dodomarg/cad-mouse-mk2/enclosure/FreeCAD/original/README.md

License: CC-BY-NC-SA 4.0

The files in this folder were created by relikd.

The original design is by [Salim Benbouziyane](https://github.com/sb-ocr/cad-mouse-mk2).
