dodomarg/cad-mouse-mk2/enclosure/FreeCAD/print-improvements/base-shell-bottom.FCStd

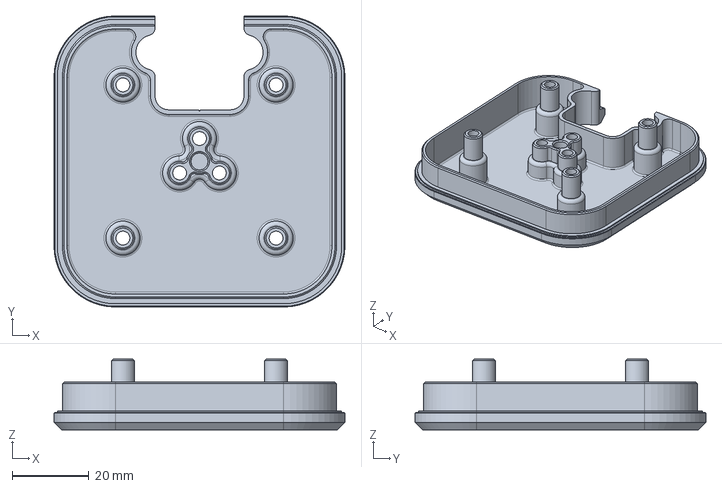
[picture p2: CAD file, 2026-06-14]
enclosure/FreeCAD/print-improvements/base-shell-bottom.FCStd
76.0 x 76.0 x 18.5 mm
