dodomarg/cad-mouse-mk2/enclosure/fusion/stl/knob.stl

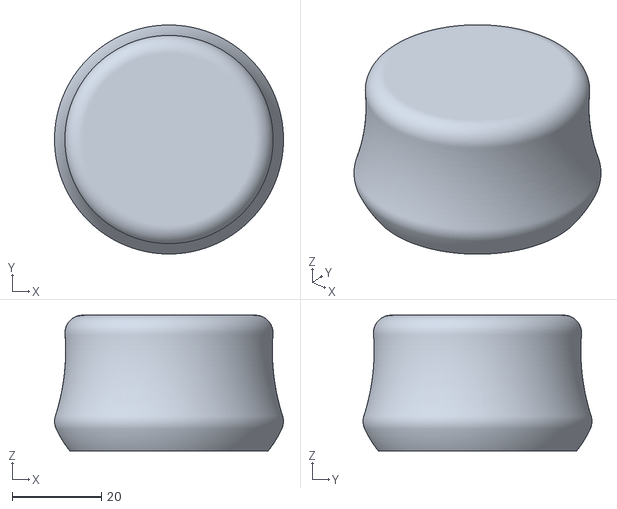
[picture p3: CAD file, 2026-06-14]
enclosure/fusion/stl/knob.stl
51.5 x 51.5 x 30.5
