dodomarg/cad-mouse-mk2/pcbs/src/SK6812 SIDE-A--3DModel-STEP-269445.STEP

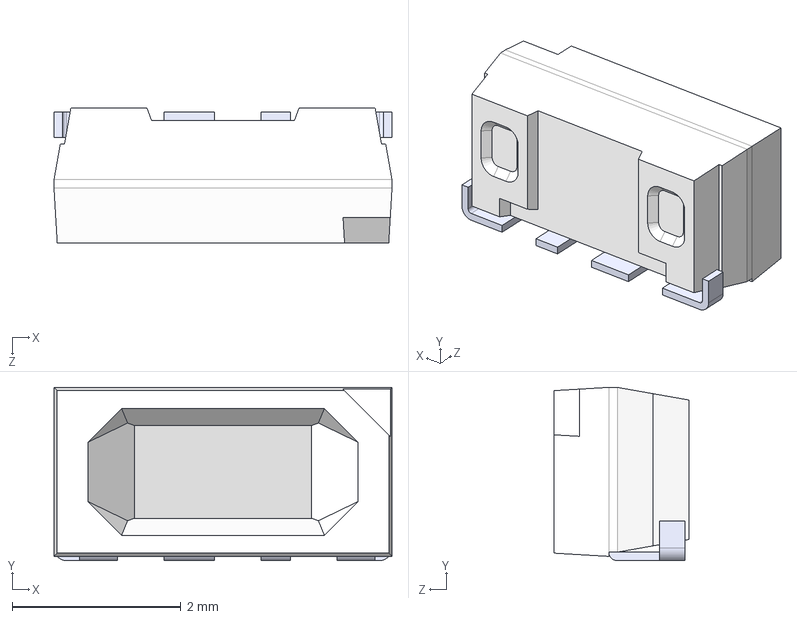
[picture p4: CAD file, 2026-06-14]
pcbs/src/SK6812 SIDE-A--3DModel-STEP-269445.STEP
4.00 x 2.05 x 1.60 mm
