dodomarg/cad-mouse-mk2/enclosure/FreeCAD/original/stem.FCStd

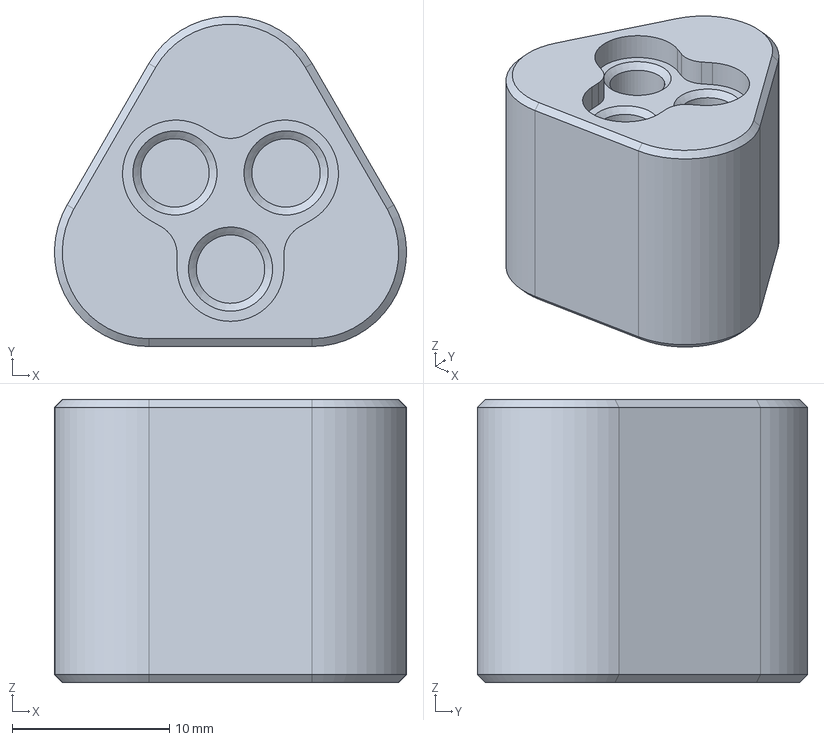
[picture p5: CAD file, 2026-06-14]
enclosure/FreeCAD/original/stem.FCStd
22.4 x 21.0 x 18.0 mm
