dodomarg/cad-mouse-mk2/enclosure/FreeCAD/print-improvements/button.FCStd

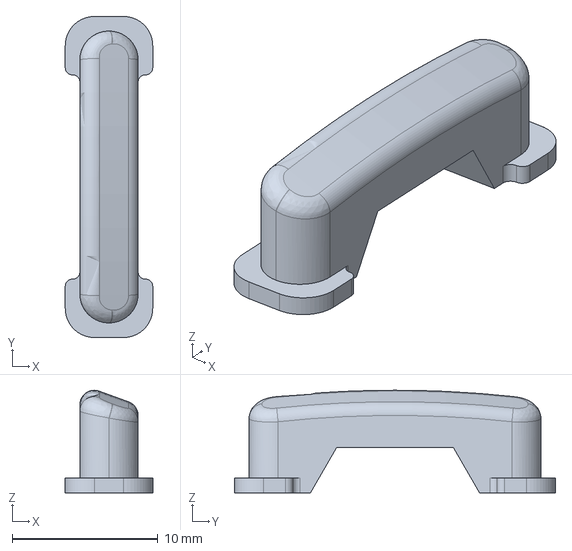
[picture p6: CAD file, 2026-06-14]
enclosure/FreeCAD/print-improvements/button.FCStd
6.00 x 22.0 x 7.03 mm
