dodomarg/cad-mouse-mk2/enclosure/fusion/stl/base_separator.stl

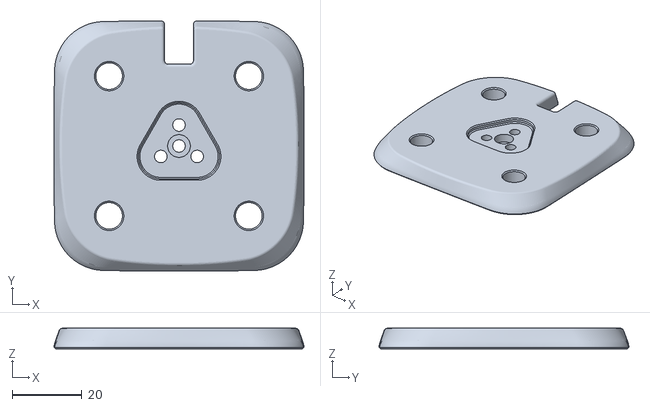
[picture p7: CAD file, 2026-06-14]
enclosure/fusion/stl/base_separator.stl
71.6 x 71.6 x 5.90
