dodomarg/cad-mouse-mk2/pcbs/src/TS32-7-35-BK-B-160-RA-SMT-TR.step

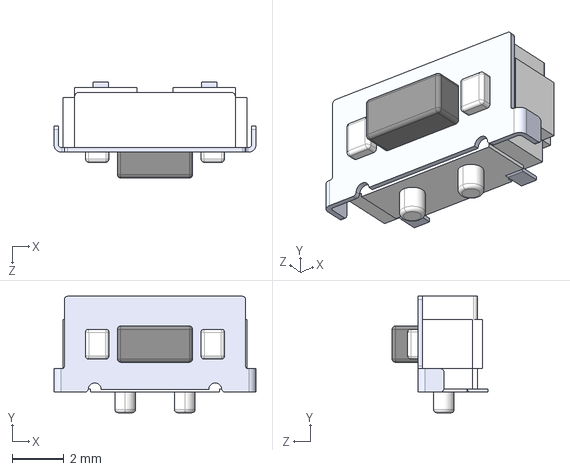
[picture p8: CAD file, 2026-06-14]
pcbs/src/TS32-7-35-BK-B-160-RA-SMT-TR.step
7.80 x 4.50 x 3.70 mm
