dodomarg/cad-mouse-mk2/enclosure/FreeCAD/original/diffuser.FCStd

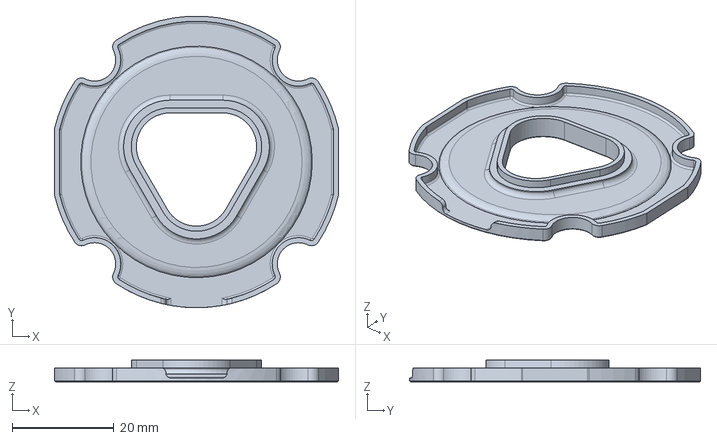
[picture p9: CAD file, 2026-06-14]
enclosure/FreeCAD/original/diffuser.FCStd
55.7 x 57.2 x 4.25 mm
