dodomarg/cad-mouse-mk2/enclosure/FreeCAD/print-improvements/base-bottom-lid.FCStd

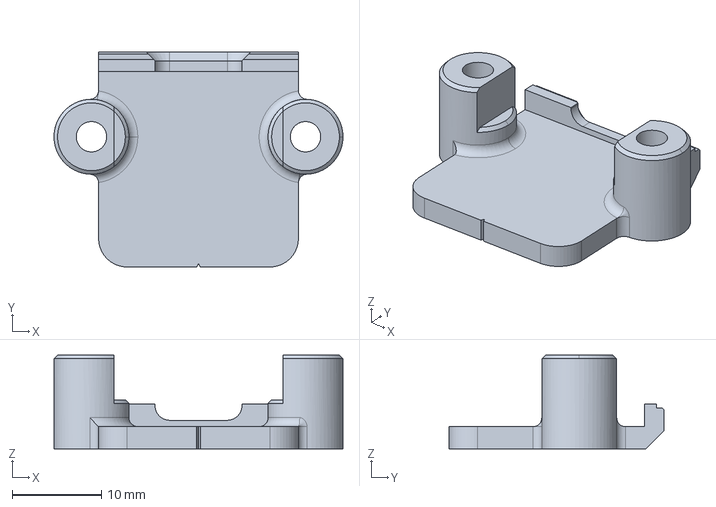
[picture p10: CAD file, 2026-06-14]
enclosure/FreeCAD/print-improvements/base-bottom-lid.FCStd
32.4 x 24.1 x 10.5 mm
