dodomarg/cad-mouse-mk2/enclosure/FreeCAD/original/magnet-holder.FCStd

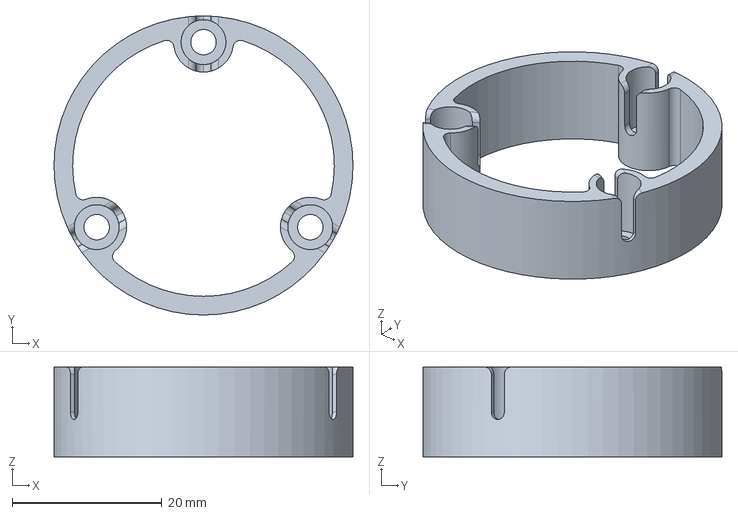
[picture p12: CAD file, 2026-06-14]
enclosure/FreeCAD/original/magnet-holder.FCStd
40.0 x 40.0 x 12.0 mm
