dodomarg/cad-mouse-mk2/enclosure/fusion/stl/base_shell_top.stl

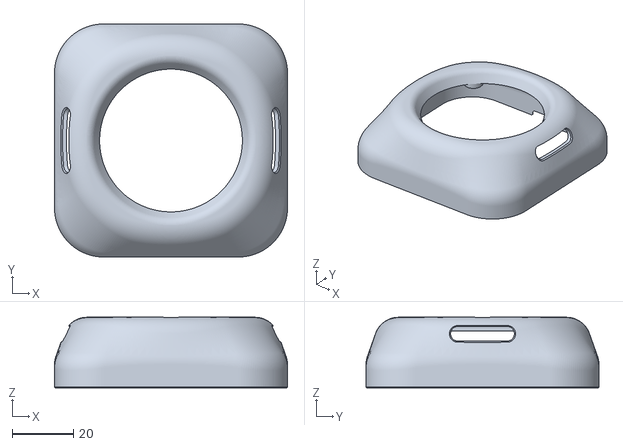
[picture p13: CAD file, 2026-06-14]
enclosure/fusion/stl/base_shell_top.stl
76.0 x 76.0 x 23.0
