dodomarg/cad-mouse-mk2/enclosure/fusion/stl/base_mcu_cover.stl

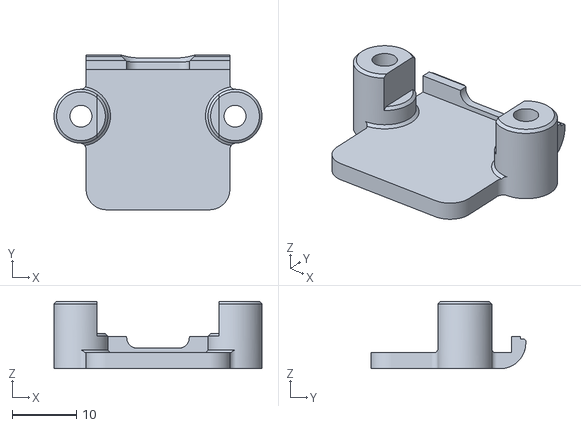
[picture p15: CAD file, 2026-06-14]
enclosure/fusion/stl/base_mcu_cover.stl
32.4 x 24.1 x 10.5
