dodomarg/cad-mouse-mk2/enclosure/fusion/stl/01_spring_0_8_mm_30_deg.stl

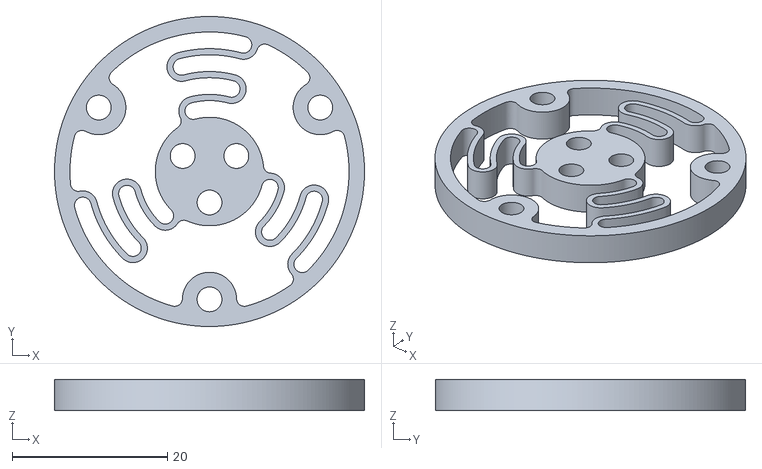
[picture p17: CAD file, 2026-06-14]
enclosure/fusion/stl/01_spring_0_8_mm_30_deg.stl
40.0 x 40.0 x 4.00
