dodomarg/cad-mouse-mk2/enclosure/fusion/stl/side_button.stl

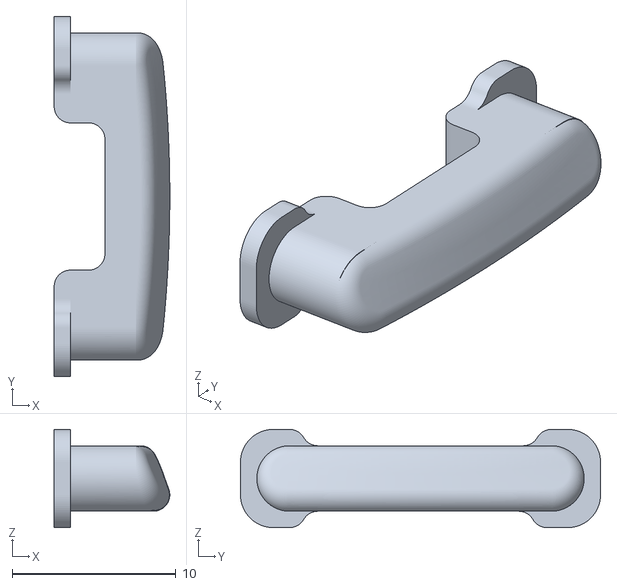
[picture p18: CAD file, 2026-06-14]
enclosure/fusion/stl/side_button.stl
7.07 x 22.0 x 6.00
