dodomarg/cad-mouse-mk2/enclosure/FreeCAD/original/spring-spacer.FCStd

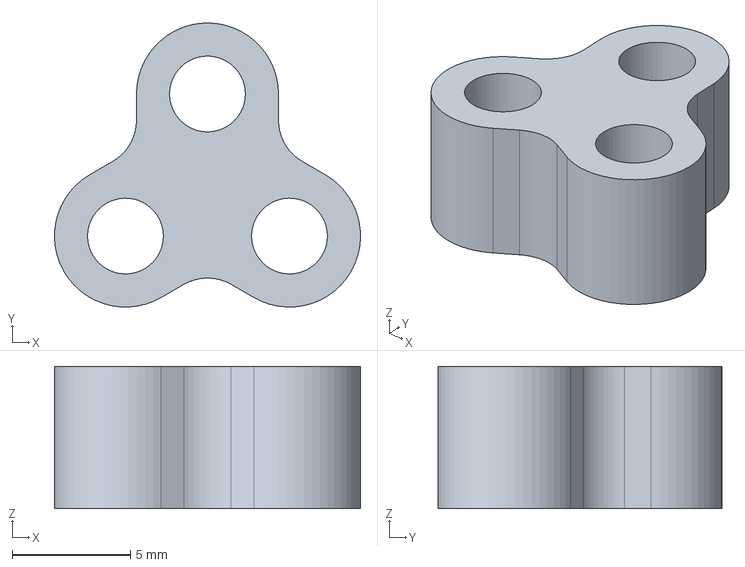
[picture p19: CAD file, 2026-06-14]
enclosure/FreeCAD/original/spring-spacer.FCStd
12.9 x 12.0 x 6.00 mm
