dodomarg/cad-mouse-mk2/enclosure/fusion/stl/diffuser.stl

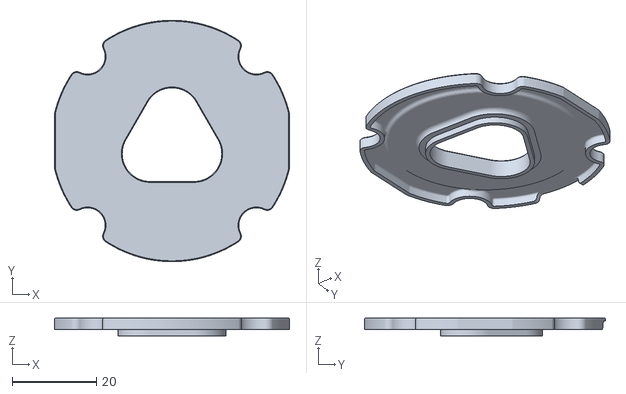
[picture p20: CAD file, 2026-06-14]
enclosure/fusion/stl/diffuser.stl
55.7 x 57.2 x 4.24
