dodomarg/cad-mouse-mk2/(list of files, cad)

Other CAD files:
enclosure/FreeCAD/original/assembly.FCStd
enclosure/FreeCAD/print-improvements/knob.FCStd
enclosure/fusion/stl/magnet_holder.stl
enclosure/fusion/stl/base_shell_bottom.stl
enclosure/FreeCAD/original/base-separator.FCStd
enclosure/FreeCAD/original/knob.FCStd
enclosure/FreeCAD/original/base-shell-top.FCStd
enclosure/fusion/stl/stem.stl
enclosure/FreeCAD/original/spring.FCStd
enclosure/fusion/stl/spring_spacer.stl
enclosure/FreeCAD/original/base-shell-bottom.FCStd
