dodomarg/cad-mouse-mk2/pcbs/src/mcu_adapter.kicad_pcb

## KiCad design pcbs/src/mcu_adapter.kicad_pcb (2026-06-14)

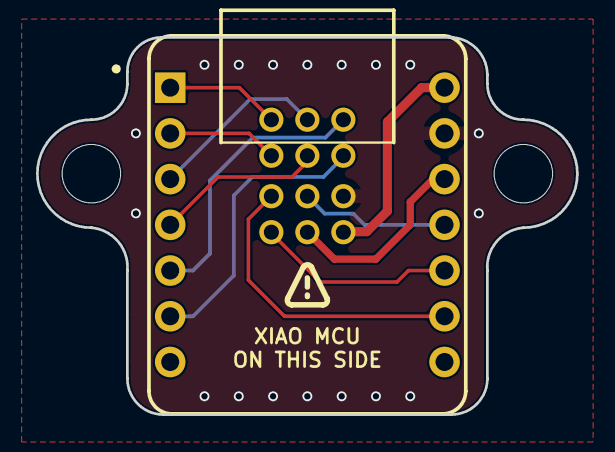
[picture p22: board mcu_adapter.kicad_pcb from above]

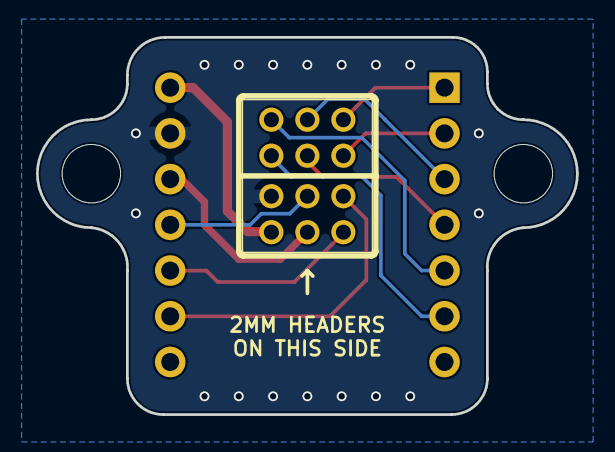
[picture p23: board mcu_adapter.kicad_pcb from below]

Board: 2 copper layers, 30.0 x 21.0 mm, 5 parts (2 on the bottom side), 12 nets.

Parts:
U1: XIAO-THRUHOLE; XIAO-GENERIC-THRUHOLE-MODULE14P-2.54-21X17.8MM_vf.79dh4xraR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
U$1, U$2: NRPN032PAEN-RC; CONN3X2_NRPN032PAEN-RC_vf.TnALXNQpQbKa17UGSM3jDw
UNK_HOLE_0: dummyfp0
UNK_HOLE_1: dummyfp1

Connections:
3V3: U1.12, U$2.3
5V: U1.14, U$2.1
D0: U1.1, U$1.6
D1: U1.2, U$1.5
D2: U1.3, U$1.4
D3: U1.4, U$1.3
D8: U1.9, U$2.6
D9: U1.10, U$2.5
D10: U1.11, U$2.4
GND: U1.13, U$2.2
SCL: U1.6, U$1.1
SDA: U1.5, U$1.2
