dodomarg/cad-mouse-mk2/pcbs/src/sensor_board.kicad_pcb

## KiCad design pcbs/src/sensor_board.kicad_pcb (2026-06-14)

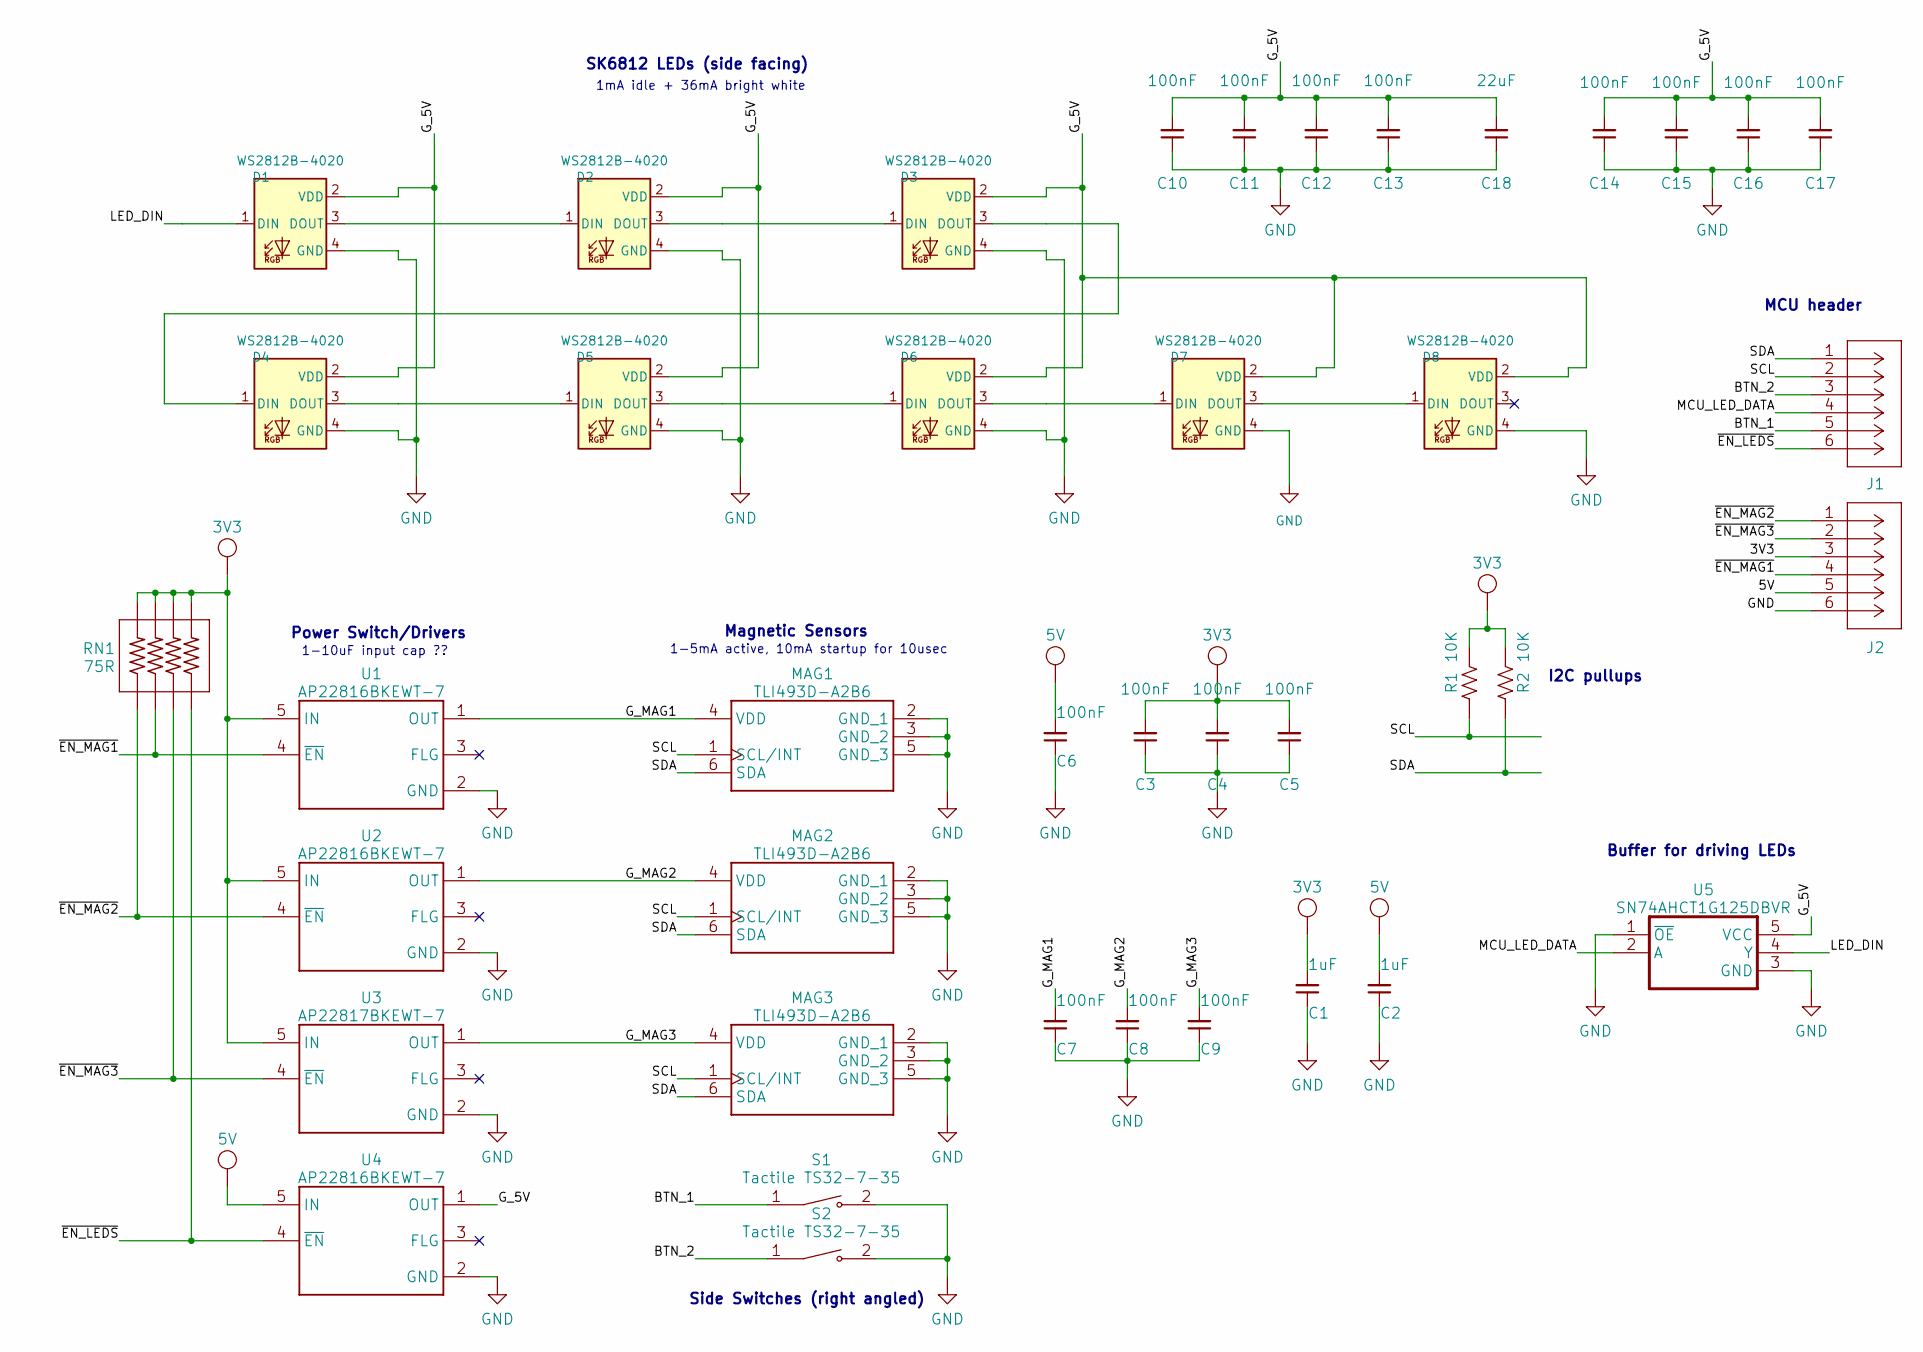
[picture p24: schematic sensor_board.kicad_sch, CAD Mouse MK2]

Parts:
C1, C2: 1uF; CAPC3216X135
C3, C4, C5, C6, C7, C8, C9, C10, C11, C12, C13, C14, C15, C16, C17: 100nF; CAPC2012X110
C18: 22uF; CAPC3216X135
D1, D2, D3, D4, D5, D6, D7, D8: WS2812B-4020
J1, J2: CONN3X2_NPPN032AFCN-RC_SUL
MAG1, MAG2, MAG3: TLI493D-A2B6; SOP95P280X110-6N-V
R1, R2: 10K; RESC2012X65
RN1: 75R; RESCAF80P320X160X60-8N
S1, S2: Tactile TS32-7-35; TS32-7-35-BK-B-160-RA-SMT-TR
U1, U2, U4: AP22816BKEWT-7; SOT95P280X100-5N
U3: AP22817BKEWT-7; SOT95P280X100-5N
U5: SN74AHCT1G125DBVR; SOT95P280X145-5N

Connections:
3V3: C1.2, C3.2, C4.2, C5.2, J2.3, R1.2, R2.2, RN1.5, RN1.6, RN1.7, RN1.8, U1.5 (IN), U2.5 (IN), U3.5 (IN)
5V: C2.2, C6.2, J2.5, U4.5 (IN)
/BTN_1: J1.5, S1.1
/BTN_2: J1.3, S2.1
/G_5V: C10.2, C11.2, C12.2, C13.2, C14.2, C15.2, C16.2, C17.2, C18.2, D1.2 (VDD), D2.2 (VDD), D3.2 (VDD), D4.2 (VDD), D5.2 (VDD), D6.2 (VDD), D7.2 (VDD), D8.2 (VDD), U4.1 (OUT), U5.5 (VCC)
/G_MAG1: C7.2, MAG1.4 (VDD), U1.1 (OUT)
/G_MAG2: C8.2, MAG2.4 (VDD), U2.1 (OUT)
/G_MAG3: C9.2, MAG3.4 (VDD), U3.1 (OUT)
/LED_DIN: D1.1 (DIN), U5.4 (Y)
/MCU_LED_DATA: J1.4, U5.2 (A)
/SCL: J1.2, MAG1.1 (SCL/INT), MAG2.1 (SCL/INT), MAG3.1 (SCL/INT), R1.1
/SDA: J1.1, MAG1.6 (SDA), MAG2.6 (SDA), MAG3.6 (SDA), R2.1
/~EN_LEDS: J1.6, RN1.4, U4.4 (~EN)
/~EN_MAG1: J2.4, RN1.2, U1.4 (~EN)
/~EN_MAG2: J2.1, RN1.1, U2.4 (~EN)
/~EN_MAG3: J2.2, RN1.3, U3.4 (~EN)
GND: C1.1, C2.1, C3.1, C4.1, C5.1, C6.1, C7.1, C8.1, C9.1, C10.1, C11.1, C12.1, C13.1, C14.1, C15.1, C16.1, C17.1, C18.1, D1.4 (GND), D2.4 (GND), D3.4 (GND), D4.4 (GND), D5.4 (GND), D6.4 (GND), D7.4 (GND), D8.4 (GND), J2.6, MAG1.2 (GND_1), MAG1.3 (GND_2), MAG1.5 (GND_3), MAG2.2 (GND_1), MAG2.3 (GND_2), MAG2.5 (GND_3), MAG3.2 (GND_1), MAG3.3 (GND_2), MAG3.5 (GND_3), S1.2, S2.2, U1.2 (GND), U2.2 (GND), U3.2 (GND), U4.2 (GND), U5.1 (~OE), U5.3 (GND)
unnamed: D1.3 (DOUT), D2.1 (DIN)
unnamed: D2.3 (DOUT), D3.1 (DIN)
unnamed: D3.3 (DOUT), D4.1 (DIN)
unnamed: D4.3 (DOUT), D5.1 (DIN)
unnamed: D5.3 (DOUT), D6.1 (DIN)
unnamed: D6.3 (DOUT), D7.1 (DIN)
unnamed: D7.3 (DOUT), D8.1 (DIN)

Notes on the sheet:
1mA idle + 36mA bright white
1-10uF input cap ??
1-5mA active, 10mA startup for 10usec
Side Switches (right angled)
Power Switch/Drivers
Magnetic Sensors
MCU header
I2C pullups
Buffer for driving LEDs
SK6812 LEDs (side facing)

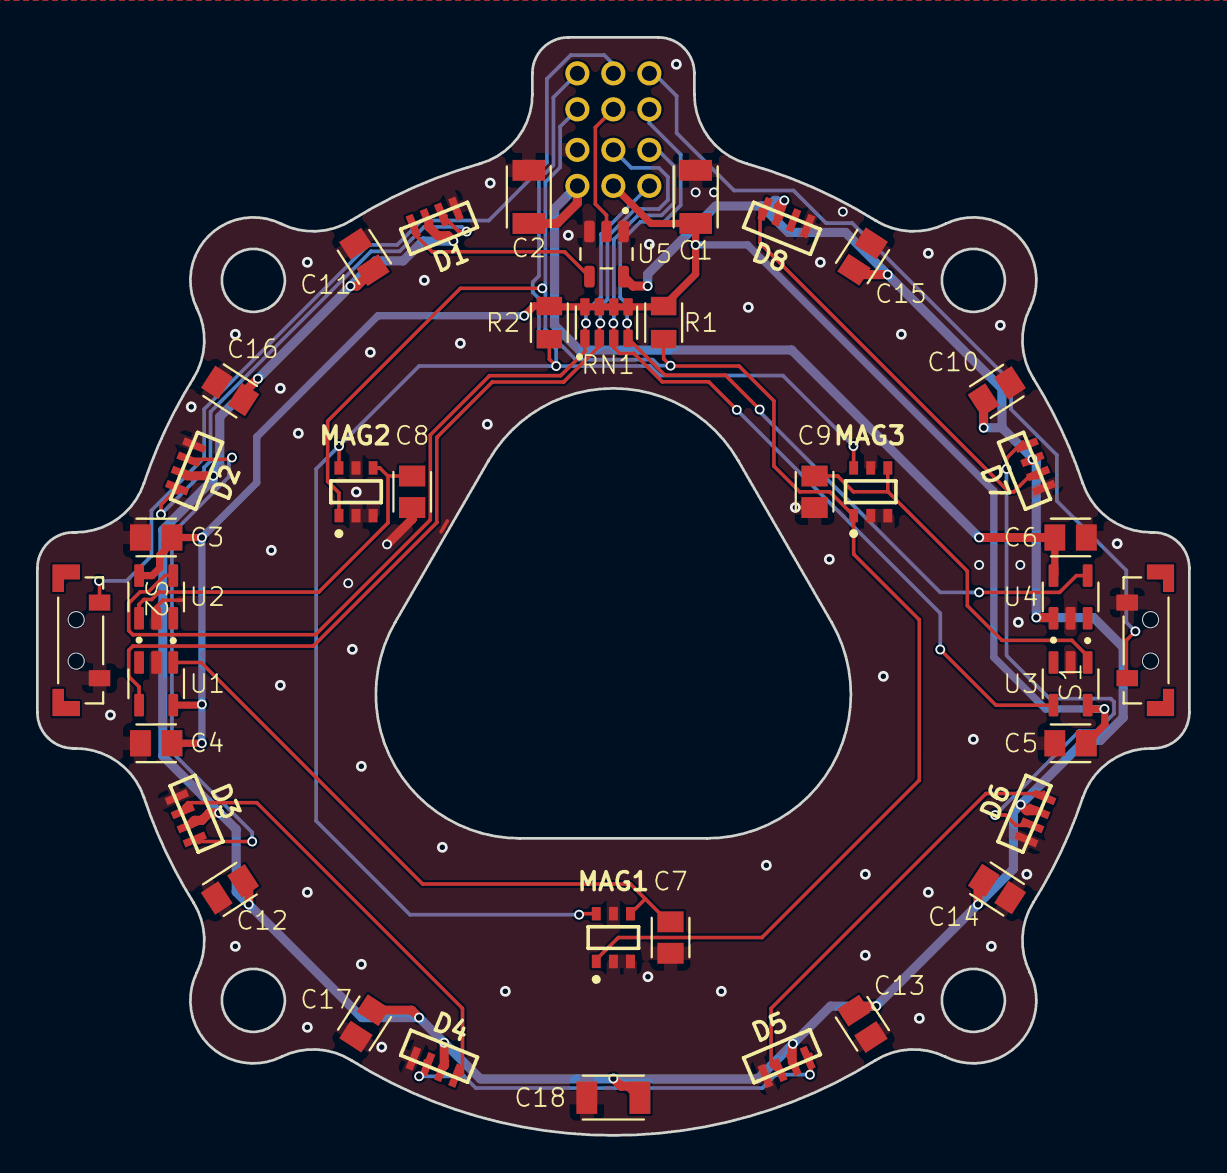
[picture p25: board sensor_board.kicad_pcb from above]

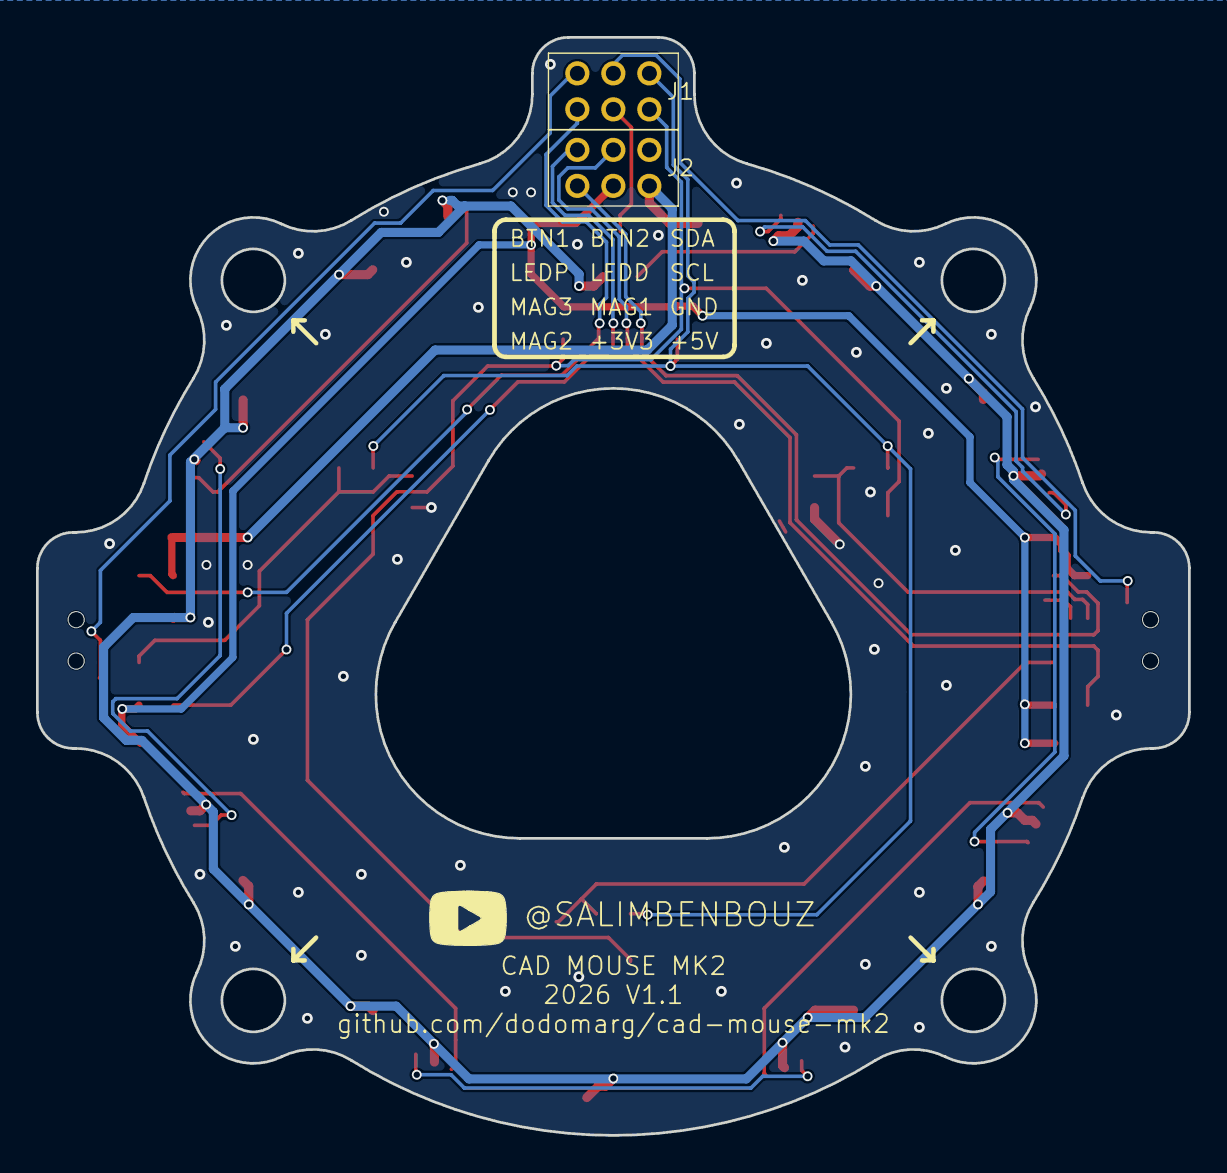
[picture p26: board sensor_board.kicad_pcb from below]

Board: 2 copper layers, 64.0 x 61.0 mm, 41 parts (2 on the bottom side), 24 nets.
