dodomarg/cad-mouse-mk2/(commit log)

2026-06-14 partial kicad project
    [SK6812 SIDE-A--3DModel-STEP-269445.STEP, TS32-7-35-BK-B-160-RA-SMT-TR.step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]
2026-06-14 re added missing kicad files
    [SK6812 SIDE-A--3DModel-STEP-269445.STEP, TS32-7-35-BK-B-160-RA-SMT-TR.step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]
2026-06-14 added gerber files for jlcpcb based on new board alterations
    [CAD Mouse MK2 _bom.csv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]
2026-06-14 updated silk screen on sensor board pcb to link to the forked repo
2026-06-14 updated BOM files
    [CAD-Mouse MK2 _bom-Assembly.csv, sensor_board_bom.csv]
2026-06-14 added FreeCAD files from https://github.com/relikd/cad-mouse-mk2-case-variations
    [00_spring_1_0_mm_30_deg.stl, 01_spring_0_8_mm_30_deg.stl, assembly.FCStd, base-bottom-lid.FCStd, base-separator.FCStd, base-shell-bottom.FCStd, base-shell-top.FCStd, base_mcu_cover.stl]
